DanielTelles91/adapter9316-27C256/README.md

# adapter9316-27C256
This adapter replaces all 6 9316 ROMs to a 27C256

Captura de tela 2024-10-10 224259
