DanielTelles91/adapter9316-27C256/Layout/Adaptador ROM Sistema/Impressão/Baixo Normal_Azul.pdf

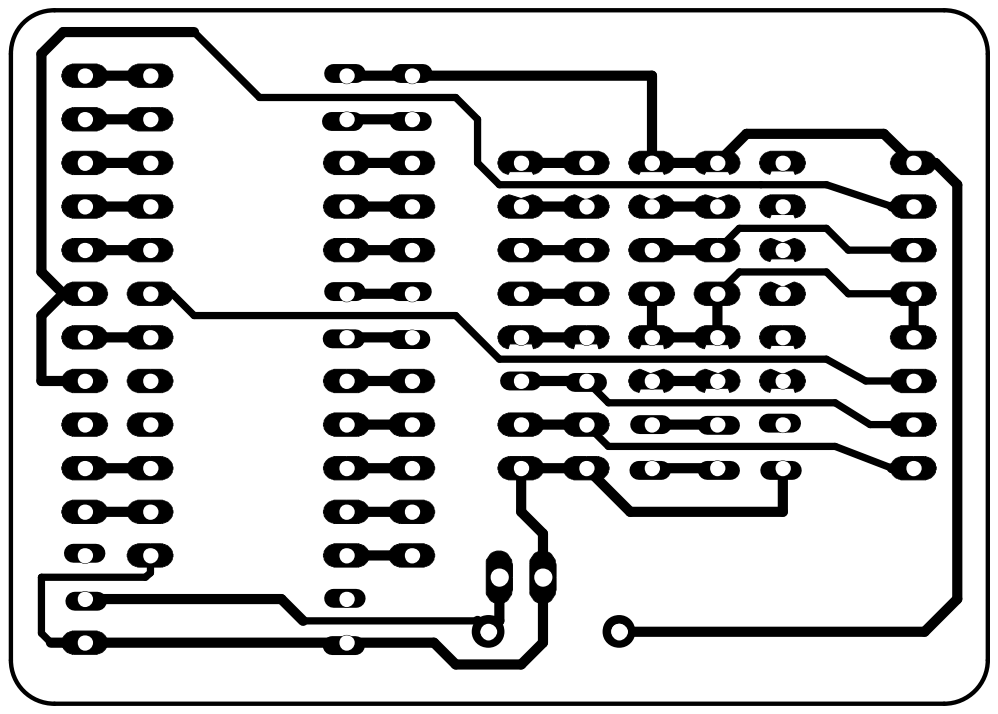
[picture p1: page 1]
