DanielTelles91/adapter9316-27C256/Layout/Adaptador ROM Sistema/Impressão/Cima Espelhado_Azul.pdf

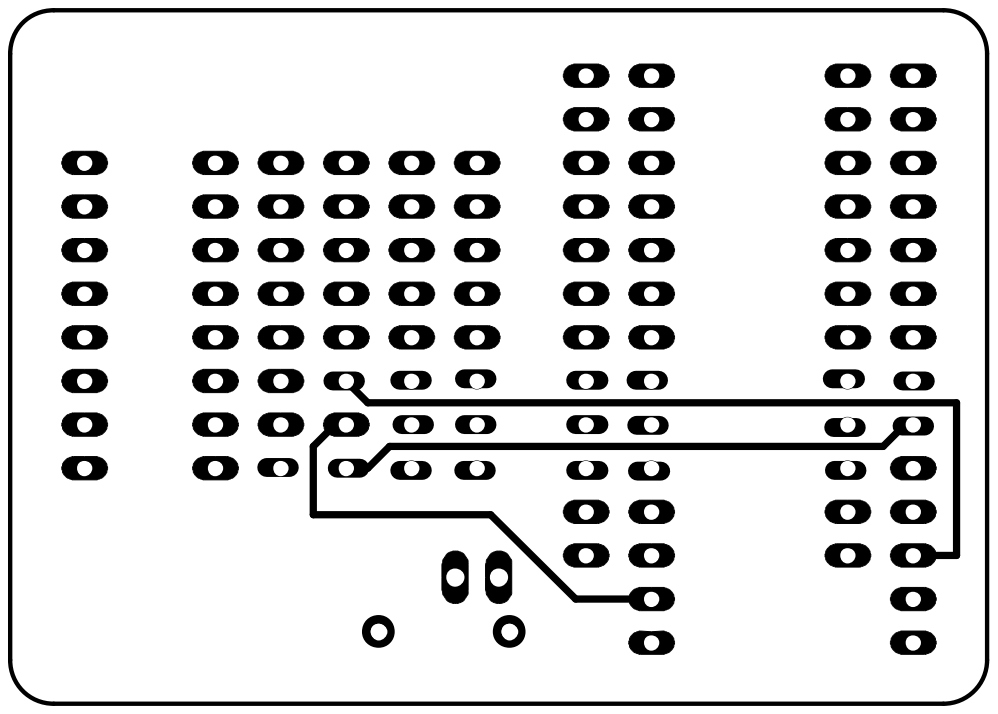
[picture p2: page 1]
